BelaPlatform/gliss-hardware/README.md

# gliss-hardware

You can find the source KiCad files for the Gliss module in this repository. This project is open hardware and under the Creative Commons Share Alike license 4.0.
The firmware can be found in the repository https://github.com/BelaPlatform/gliss-firmware
