BelaPlatform/gliss-hardware/3Dmodels/WS2812-2020.STEP

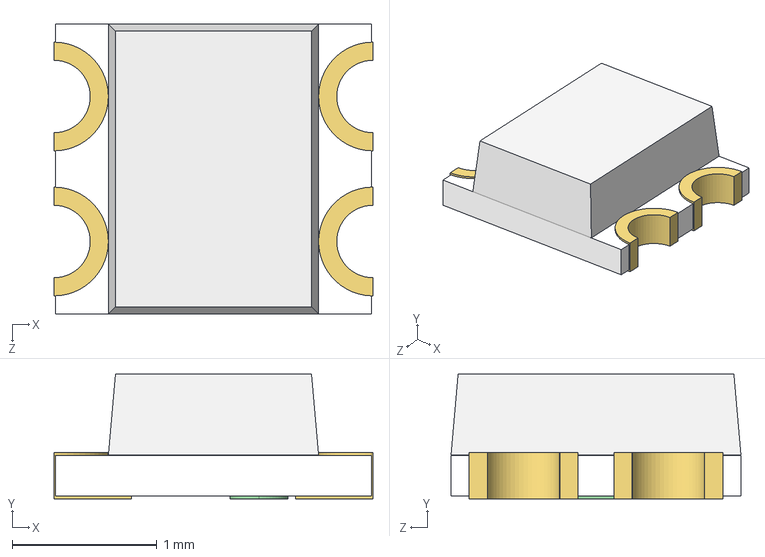
[picture p1: CAD file, 2023-10-27]
3Dmodels/WS2812-2020.STEP
2.20 x 0.86 x 2.00 mm
