BelaPlatform/gliss-hardware/3Dmodels/ECS-.327-12.5-16-TR.step

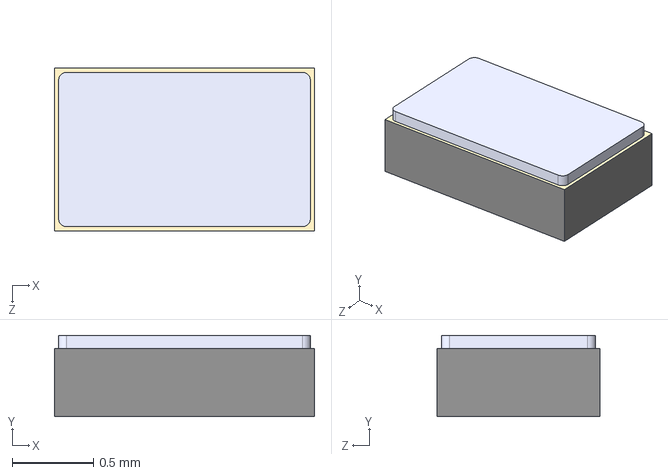
[picture p2: CAD file, 2023-10-27]
3Dmodels/ECS-.327-12.5-16-TR.step
1.60 x 0.5 x 1.00 mm
