BelaPlatform/gliss-hardware/3Dmodels/Thonkicon.step

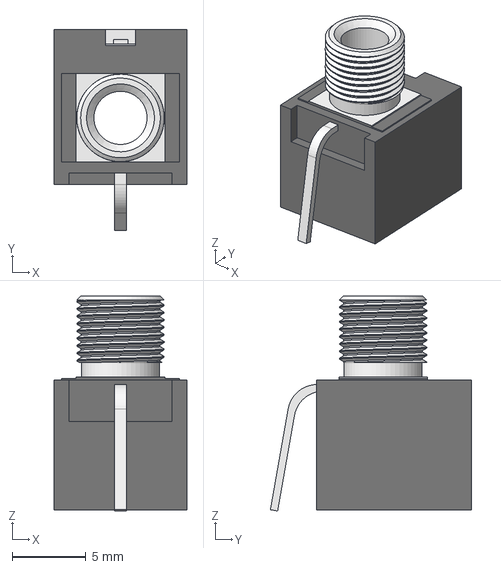
[picture p3: CAD file, 2023-10-27]
3Dmodels/Thonkicon.step
9.00 x 13.6 x 14.6 mm
