BelaPlatform/gliss-hardware/3Dmodels/ST1S06PUR.step

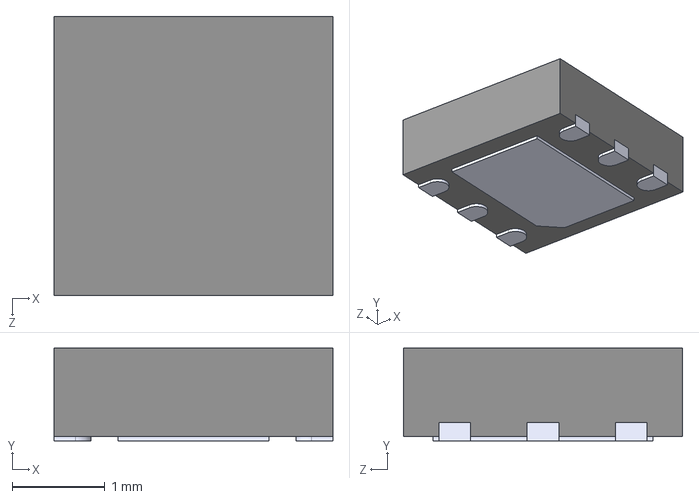
[picture p4: CAD file, 2023-10-27]
3Dmodels/ST1S06PUR.step
3.00 x 1 x 3.00 mm
