BelaPlatform/gliss-hardware/3Dmodels/R-78E5.0-0.5.STEP

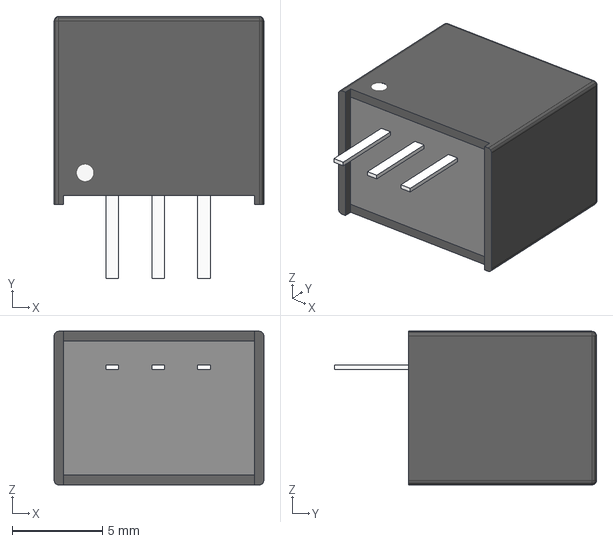
[picture p5: CAD file, 2023-10-27]
3Dmodels/R-78E5.0-0.5.STEP
11.6 x 14.5 x 8.51 mm
