BelaPlatform/gliss-hardware/3Dmodels/TPD2E001DZDR--3DModel-STEP-56544.STEP

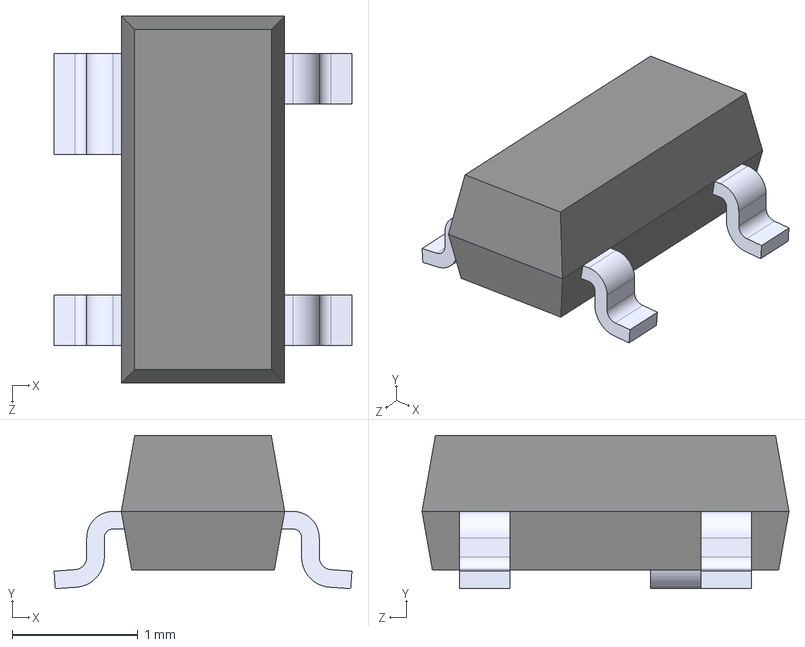
[picture p6: CAD file, 2023-10-27]
3Dmodels/TPD2E001DZDR--3DModel-STEP-56544.STEP
2.37 x 1.22 x 2.92 mm
