BelaPlatform/gliss-hardware/3Dmodels/HIGHLY_PB6149L.STEP

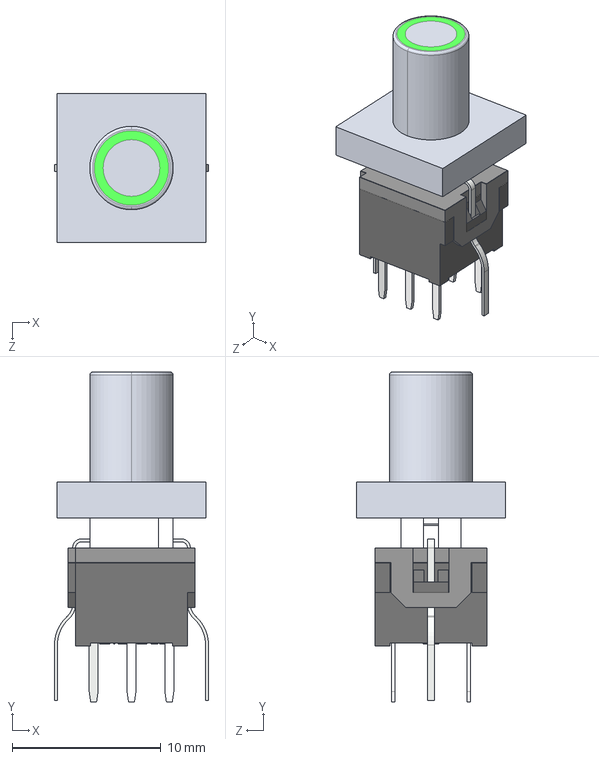
[picture p7: CAD file, 2023-10-27]
3Dmodels/HIGHLY_PB6149L.STEP
10.3 x 22.1 x 10.0 mm
Przycisk_Signal_Green_Domyślna
Switch_DPDT_bistable_Domyślna
