BelaPlatform/gliss-hardware/3Dmodels/SN74LV1T34DCKR.STEP

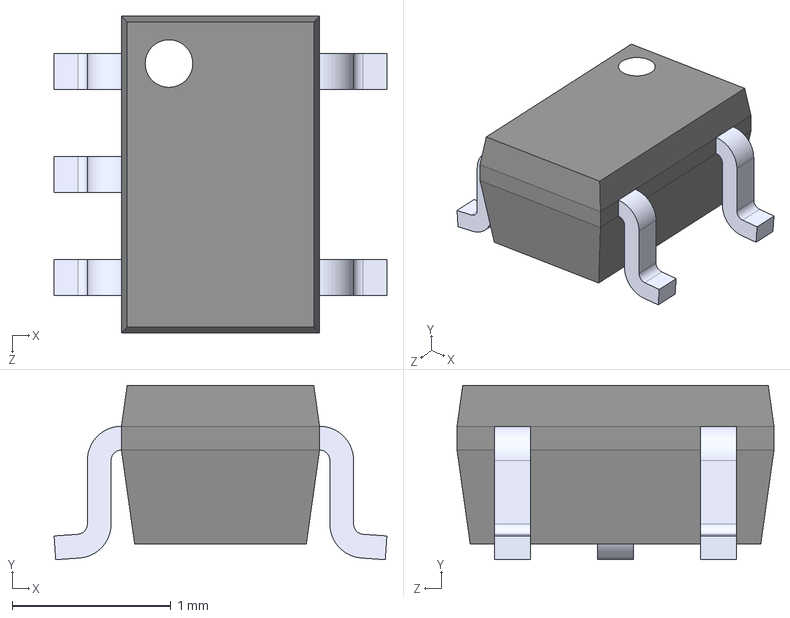
[picture p8: CAD file, 2023-10-27]
3Dmodels/SN74LV1T34DCKR.STEP
2.10 x 1.10 x 2.00 mm
