BelaPlatform/gliss-hardware/3Dmodels/10118194-0001LF--3DModel-STEP-56544.STEP

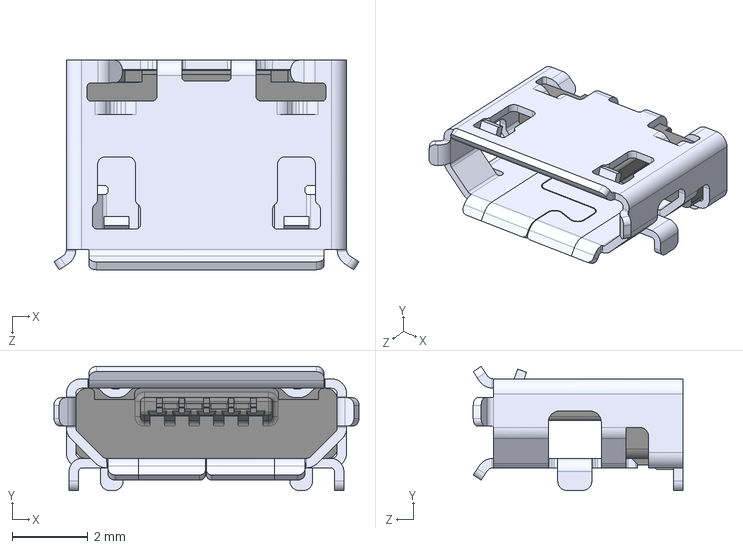
[picture p9: CAD file, 2023-10-27]
3Dmodels/10118194-0001LF--3DModel-STEP-56544.STEP
8.05 x 3.27 x 5.53 mm
