BelaPlatform/gliss-hardware/gliss_faceplate/gliss_faceplate.kicad_pcb

## KiCad design gliss_faceplate/gliss_faceplate.kicad_pcb (2023-10-27)

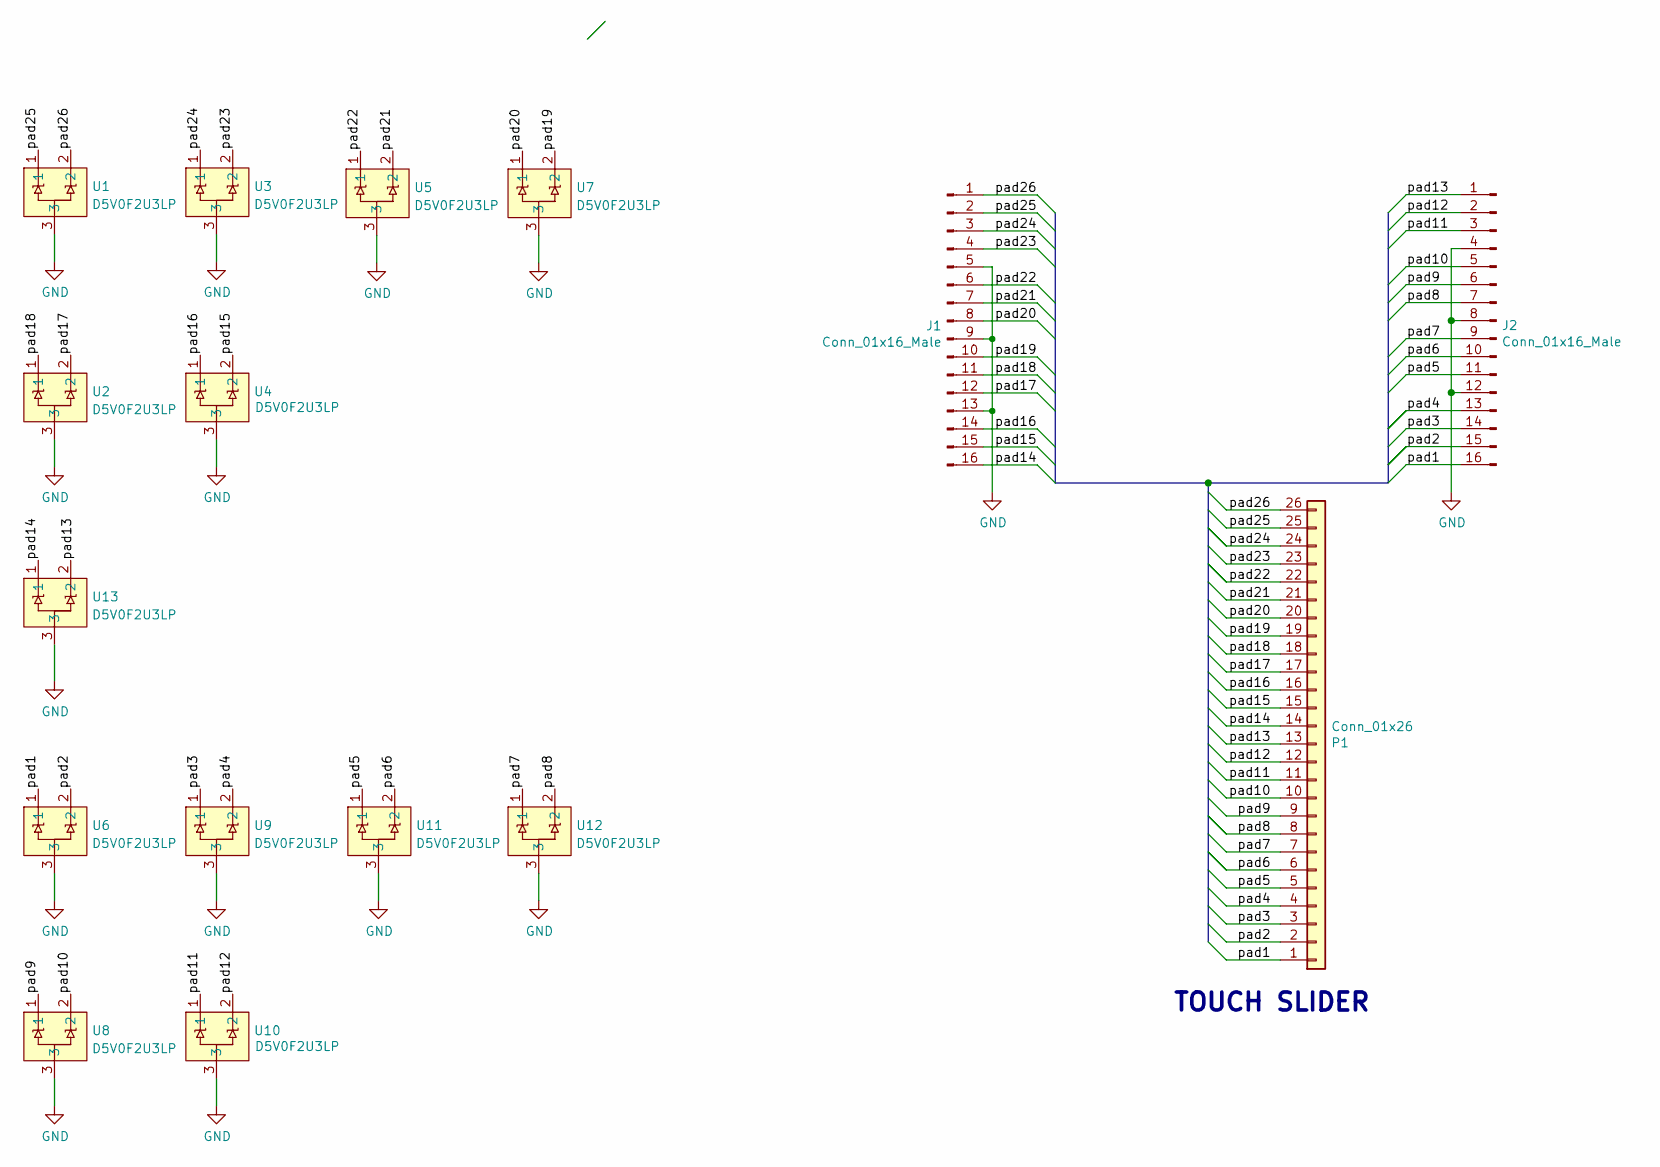
[picture p10: schematic gliss_faceplate.kicad_sch, Gliss [Faceplate]

Parts:
J1, J2: Conn_01x16_Male; PinHeader_1x16_P2.54mm_Vertical_SMD_Pin1Right
P1: Conn_01x26; TouchSlider-26_89.5x17.8mm
U1, U2, U3, U4, U5, U6, U7, U8, U9, U10, U11, U12, U13: D5V0F2U3LP; Diodes_DFN1006-3

Connections:
/pad1: J2.16, P1.1, U6.1
/pad2: J2.15, P1.2, U6.2
/pad3: J2.14, P1.3, U9.1
/pad4: J2.13, P1.4, U9.2
/pad5: J2.11, P1.5, U11.1
/pad6: J2.10, P1.6, U11.2
/pad7: J2.9, P1.7, U12.1
/pad8: J2.7, P1.8, U12.2
/pad9: J2.6, P1.9, U8.1
/pad10: J2.5, P1.10, U8.2
/pad11: J2.3, P1.11, U10.1
/pad12: J2.2, P1.12, U10.2
/pad13: J2.1, P1.13
/pad14: J1.16, P1.14, U13.1
/pad15: J1.15, P1.15, U4.2
/pad16: J1.14, P1.16, U4.1
/pad17: J1.12, P1.17, U2.2
/pad18: J1.11, P1.18, U2.1
/pad19: J1.10, P1.19, U7.2
/pad20: J1.8, P1.20, U7.1
/pad21: J1.7, P1.21, U5.2
/pad22: J1.6, P1.22, U5.1
/pad23: J1.4, P1.23, U3.2
/pad24: J1.3, P1.24, U3.1
/pad25: J1.2, P1.25, U1.1
/pad26: J1.1, P1.26, U1.2
GND: J1.5, J1.9, J1.13, J2.4, J2.8, J2.12, U1.3, U2.3, U3.3, U4.3, U5.3, U6.3, U7.3, U8.3, U9.3, U10.3, U11.3, U12.3, U13.3

Notes on the sheet:
TOUCH SLIDER

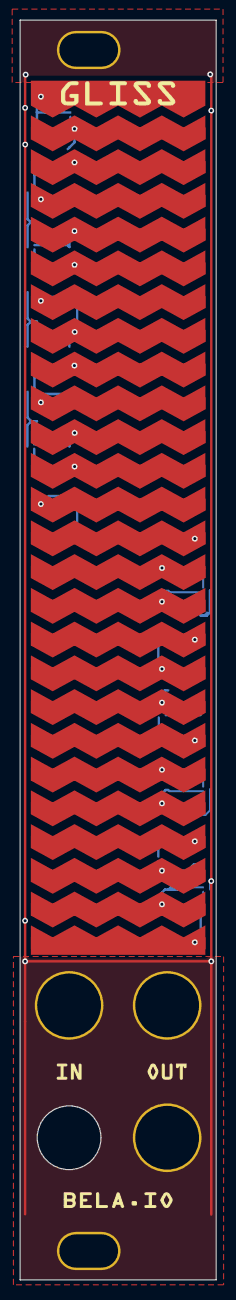
[picture p11: board gliss_faceplate.kicad_pcb from above]

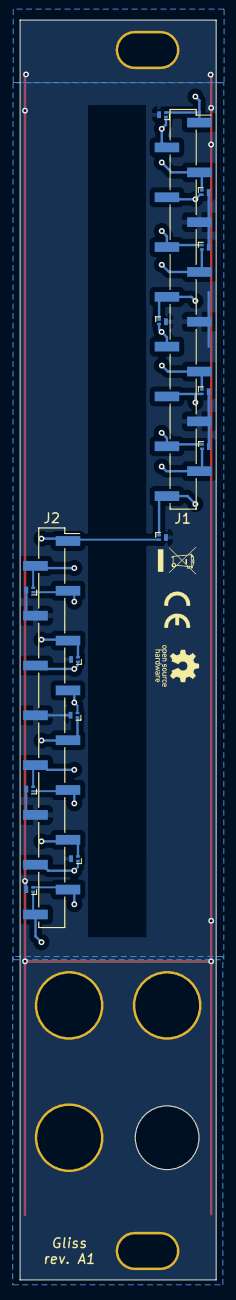
[picture p12: board gliss_faceplate.kicad_pcb from below]

Board: 2 copper layers, 20.0 x 128.5 mm, 17 parts (15 on the bottom side), 27 nets.

Other parts of the board:
outline: Val**; gliss_edge_silkscreen
