BelaPlatform/gliss-hardware/gliss_main/gliss_main.kicad_pcb

## KiCad design gliss_main/gliss_main.kicad_pcb (2023-10-27)

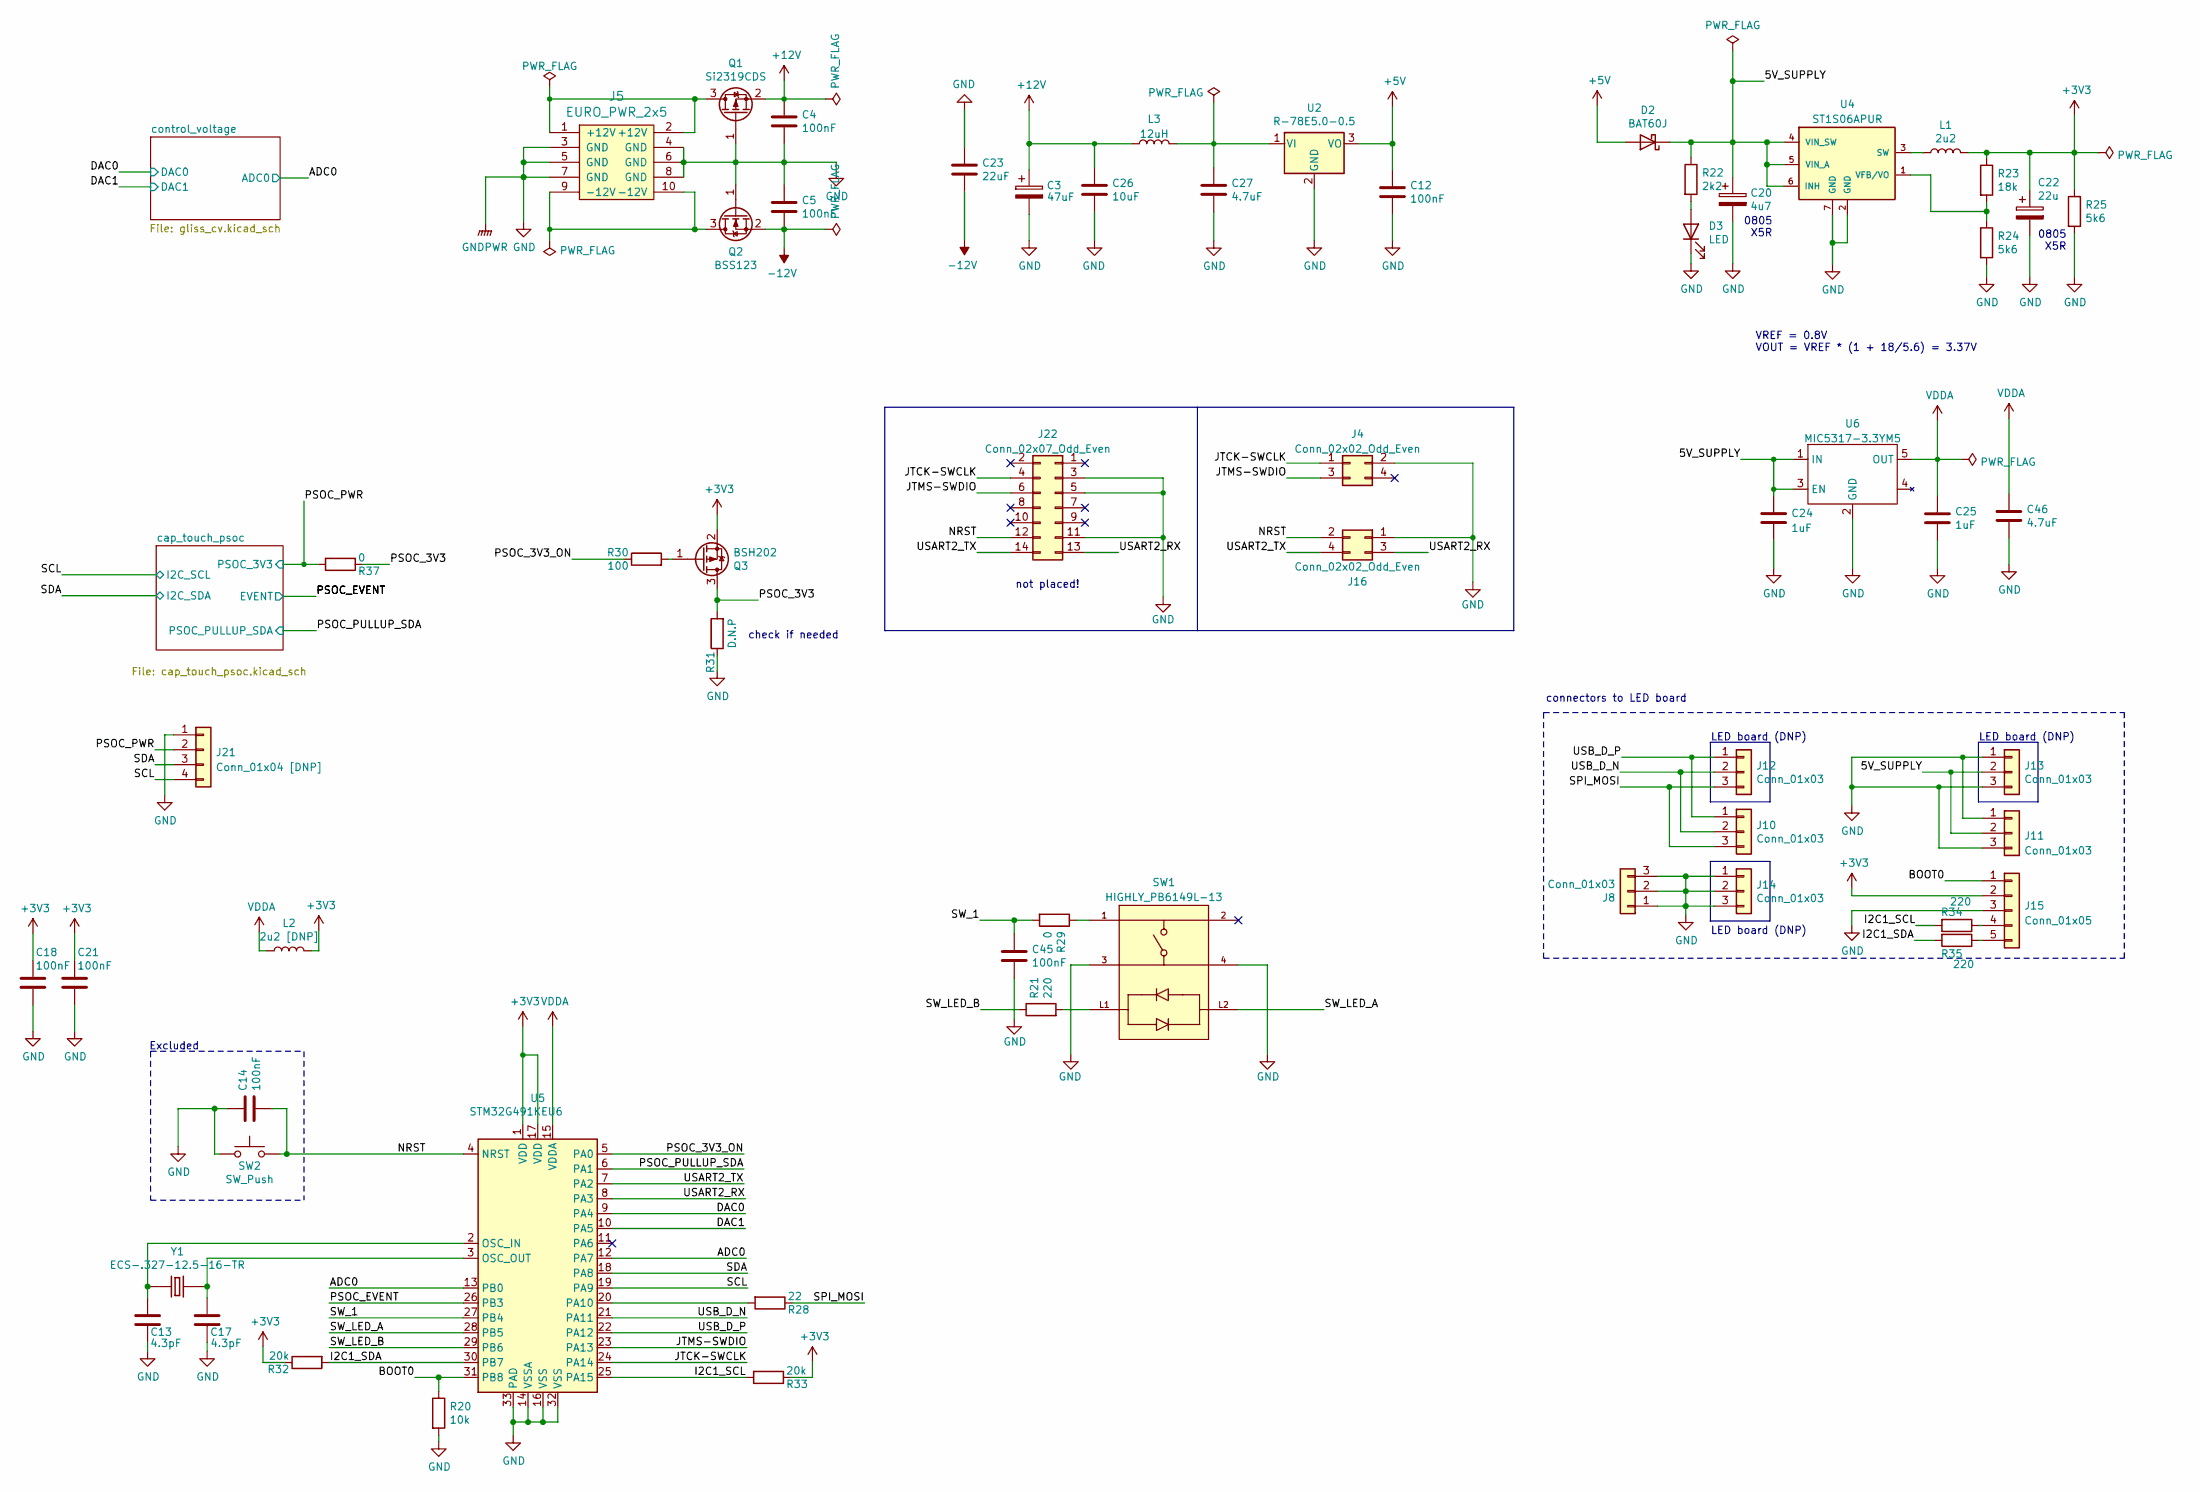
[picture p13: schematic gliss_main.kicad_sch]

Parts:
C3: 47uF; CP_Radial_D5.0mm_P2.00mm
C4, C5: 100nF; C_0805_2012Metric
C12: 100nF; C_0603_1608Metric
C13, C17: 4.3pF; C_0402_1005Metric
C14, C18, C21, C45: 100nF; C_0402_1005Metric
C20: 4u7; C_0805_2012Metric
C22: 22u; C_0805_2012Metric
C23: 22uF; C_0805_2012Metric
C24, C25: 1uF; C_0402_1005Metric
C26: 10uF; C_0603_1608Metric
C27: 4.7uF; C_0603_1608Metric
C46: 4.7uF; C_0402_1005Metric
D2: BAT60J; D_SOD-323
D3: LED; LED_0603_1608Metric
J4, J16: Conn_02x02_Odd_Even; PinHeader_2x02_P1.27mm_Vertical
J5: EURO_PWR_2x5; PinHeader_2x05_P2.54mm_Vertical
J8, J10, J11: Conn_01x03; PinHeader_1x03_P2.54mm_Vertical
J12, J13, J14: Conn_01x03; PinHeader_1x03_P2.54mm_Vertical_SMD_Pin1Left
J15: Conn_01x05; PinHeader_1x05_P2.54mm_Vertical
J21: Conn_01x04 [DNP]; PinHeader_1x04_P1.27mm_Vertical
J22: Conn_02x07_Odd_Even; PinHeader_2x07_P1.27mm_Vertical
L1: 2u2; L_0603_1608Metric
L2: 2u2 [DNP]; L_0603_1608Metric
L3: 12uH; L_1210_3225Metric
Q1: Si2319CDS; SOT-23
Q2: BSS123; SOT-23
Q3: BSH202; SOT-23
R20: 10k; R_0402_1005Metric
R21, R34, R35: 220; R_0402_1005Metric
R22: 2k2; R_0402_1005Metric
R23: 18k; R_0402_1005Metric
R24, R25: 5k6; R_0402_1005Metric
R28: 22; R_0402_1005Metric
R29, R37: 0; R_0402_1005Metric
R30: 100; R_0402_1005Metric
R31: D.N.P; R_0402_1005Metric
R32, R33: 20k; R_0402_1005Metric
SW1: HIGHLY_PB6149L-13; HIGHLY_PB6149L_v4
SW2: SW_Push; SW_SPST_B3U-1000P
U2: R-78E5.0-0.5; R-78-xxx-0.5
U4: ST1S06APUR; DFN-6-1EP_3x3mm_P0.95mm_EP1.7x2.6mm
U5: STM32G491KEU6; QFN-32-1EP_5x5mm_P0.5mm_EP3.45x3.45mm
U6: MIC5317-3.3YM5; TSOT-23-5
Y1: ECS-.327-12.5-16-TR; XTAL_ECS-.327-12.5-16-TR

Connections:
+3V3: C18.1, C21.1, C22.1, J15.2, L1.2, L2.2, Q3.2 (S), R23.1, R25.1, R32.1, R33.1, U5.1 (VDD), U5.17 (VDD); also elsewhere on the board
+5V: C12.1, D2.2 (A), U2.3 (VO)
+12V: C3.1, C4.1, C26.1, L3.1, Q1.2 (S); also elsewhere on the board
-12V: C5.2, C23.2, Q2.2 (S); also elsewhere on the board
/5V_SUPPLY: C20.1, C24.1, D2.1 (K), J11.2, J13.2, R22.1, U4.4 (VIN_SW), U4.5 (VIN_A), U4.6 (INH), U6.1 (IN), U6.3 (EN)
/ADC0: U5.12 (PA7), U5.13 (PB0); also elsewhere on the board
/BOOT0: J15.1, R20.1, U5.31 (PB8)
/DAC0: U5.9 (PA4); also elsewhere on the board
/DAC1: U5.10 (PA5); also elsewhere on the board
/I2C1_SCL: R33.2, R34.2, U5.25 (PA15)
/I2C1_SDA: R32.2, R35.2, U5.30 (PB7)
/JTCK-SWCLK: J4.1, J22.4, U5.24 (PA14)
/JTMS-SWDIO: J4.3, J22.6, U5.23 (PA13)
/NRST: C14.2, J16.2, J22.12, SW2.2, U5.4 (NRST)
/PSOC_3V3: Q3.3 (D), R31.2, R37.1
/PSOC_3V3_ON: R30.1, U5.5 (PA0)
/PSOC_EVENT: U5.26 (PB3); also elsewhere on the board
/PSOC_PULLUP_SDA: U5.6 (PA1); also elsewhere on the board
/PSOC_PWR: J21.2, R37.2; also elsewhere on the board
/SCL: J21.4, U5.19 (PA9); also elsewhere on the board
/SDA: J21.3, U5.18 (PA8); also elsewhere on the board
/SPI_MOSI: J10.3, J12.3, R28.1
/SW_1: C45.1, R29.2, U5.27 (PB4)
/SW_LED_A: SW1.L2, U5.28 (PB5)
/SW_LED_B: R21.1, U5.29 (PB6)
/USART2_RX: J16.3, J22.13, U5.8 (PA3)
/USART2_TX: J16.4, J22.14, U5.7 (PA2)
/USB_D_N: J10.2, J12.2, U5.21 (PA11)
/USB_D_P: J10.1, J12.1, U5.22 (PA12)
GND: C3.2, C4.2, C5.1, C12.2, C13.2, C14.1, C17.2, C18.2, C20.2, C21.2, C22.2, C23.1, C24.2, C25.2, C26.2, C27.2, C45.2, C46.2, D3.1 (K), J4.2, J5.3 (GND), J5.4 (GND), J5.5 (GND), J5.6 (GND), J5.7 (GND), J5.8 (GND), J8.1, J8.2, J8.3, J11.1, J11.3, J13.1, J13.3, J14.1, J14.2, J14.3, J15.3, J16.1, J21.1, J22.3, J22.5, J22.11, Q1.1 (G), Q2.1 (G), R20.2, R24.2, R25.2, R31.1, SW1.3, SW1.4, SW2.1, U2.2 (GND), U4.2 (GND), U4.7 (GND), U5.14 (VSSA), U5.16 (VSS), U5.32 (VSS), U5.33 (PAD), U6.2 (GND); also elsewhere on the board
unnamed: C13.1, U5.2 (OSC_IN), Y1.1
unnamed: C17.1, U5.3 (OSC_OUT), Y1.2
unnamed: C27.1, L3.2, U2.1 (VI)
unnamed: D3.2 (A), R22.2
unnamed: J5.1 (+12V), J5.2 (+12V), Q1.3 (D)
unnamed: J5.9 (-12V), J5.10 (-12V), Q2.3 (D)
unnamed: J15.4, R34.1
unnamed: J15.5, R35.1
unnamed: L1.1, U4.3 (SW)
unnamed: Q3.1 (G), R30.2
unnamed: R21.2, SW1.L1
unnamed: R23.2, R24.1, U4.1 (VFB/VO)
unnamed: R28.2, U5.20 (PA10)
unnamed: R29.1, SW1.1
VDDA: C25.1, C46.1, L2.1, U5.15 (VDDA), U6.5 (OUT)

Notes on the sheet:
Excluded
LED board (DNP)
0805 X5R
connectors to LED board
VREF = 0.8V VOUT = VREF * (1 + 18/5.6) = 3.37V
check if needed
not placed!

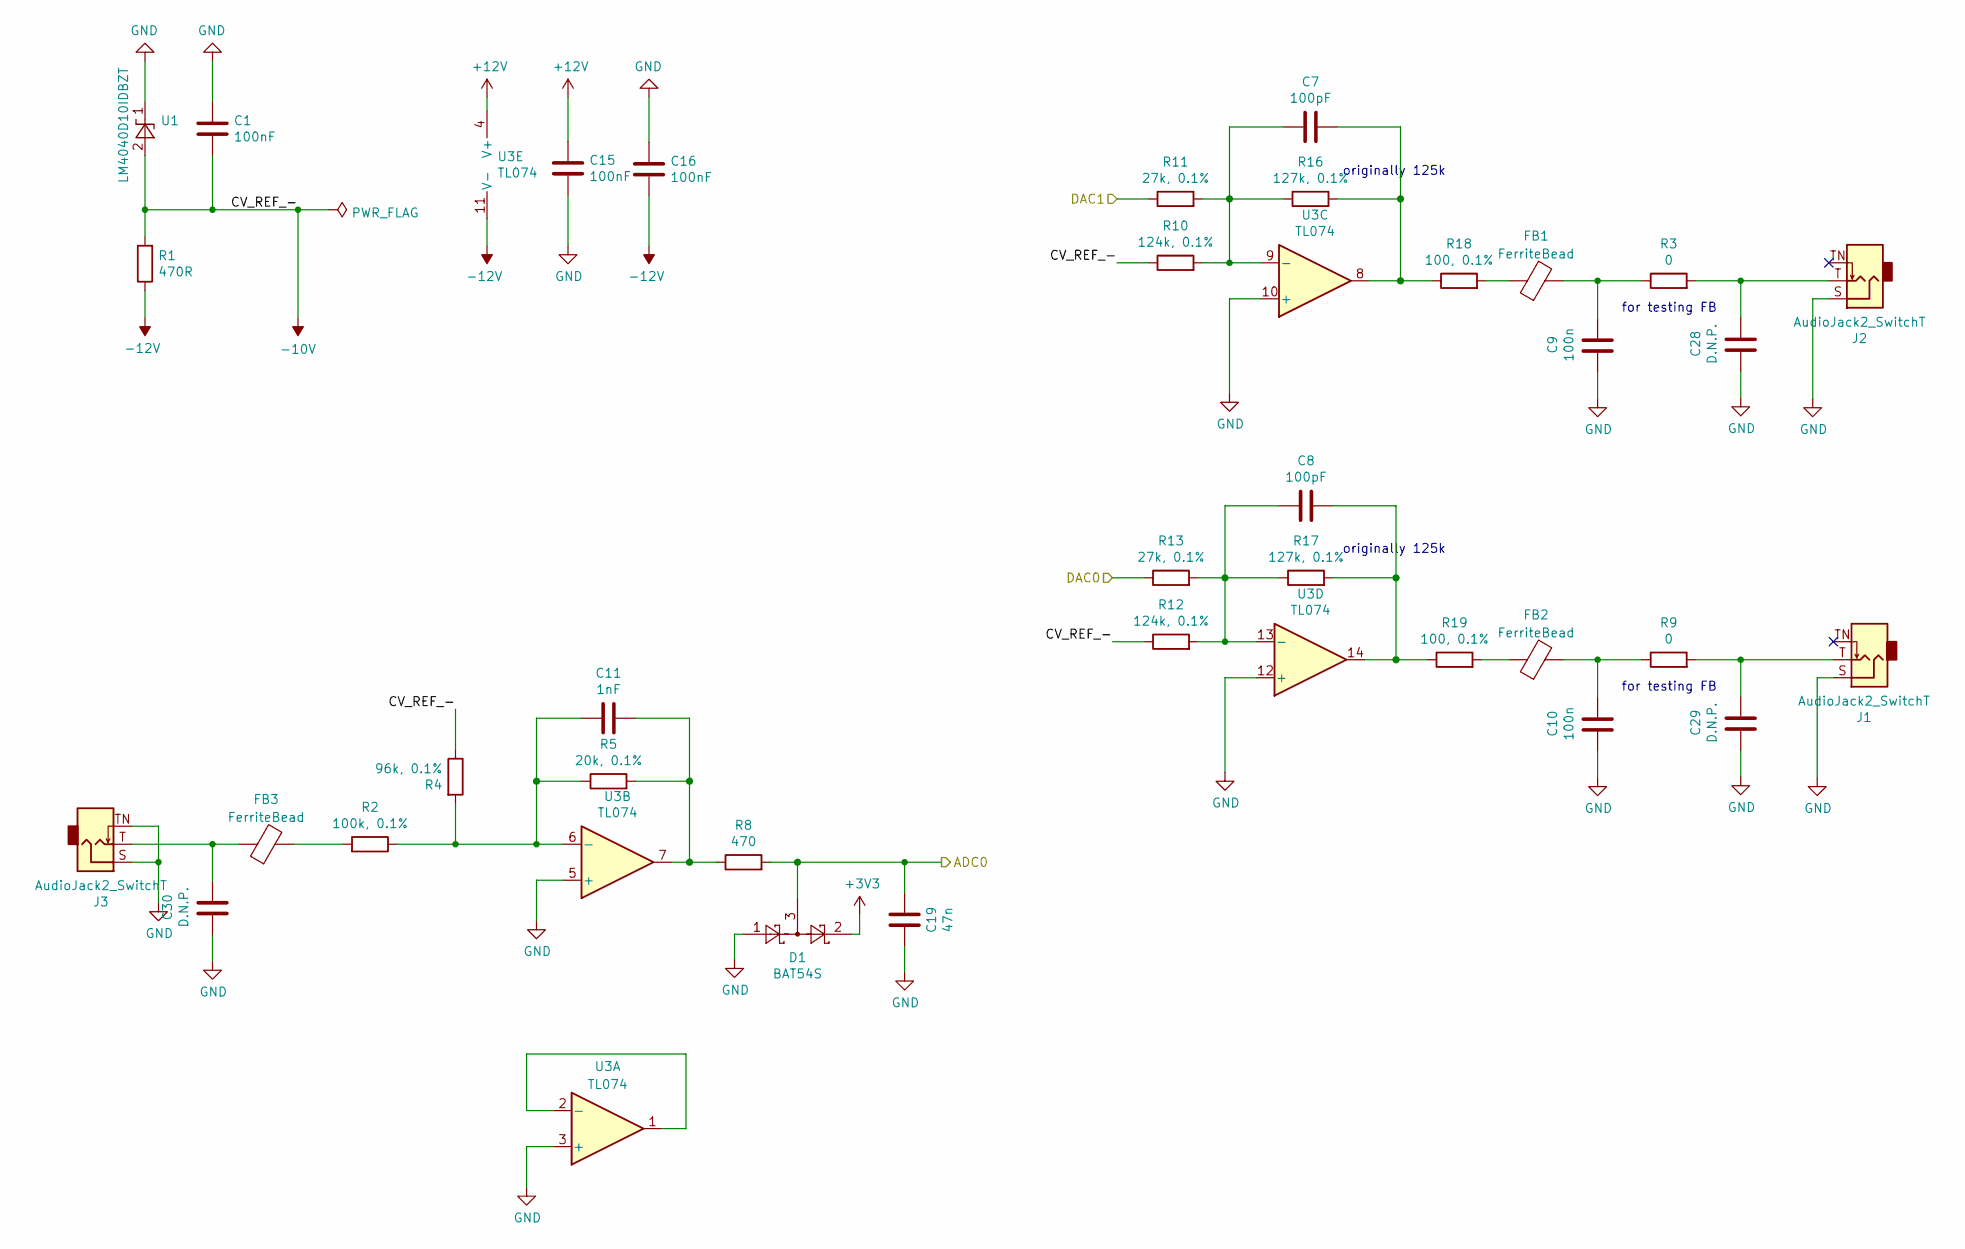
[picture p14: schematic gliss_cv.kicad_sch]

Parts:
C1, C15, C16: 100nF; C_0402_1005Metric
C7, C8: 100pF; C_0402_1005Metric
C9, C10: 100n; C_0402_1005Metric
C11: 1nF; C_0402_1005Metric
C19: 47n; C_0402_1005Metric
C28, C29, C30: D.N.P.; C_0402_1005Metric
D1: BAT54S; SOT-23
FB1, FB2, FB3: FerriteBead; L_0402_1005Metric
J1, J2, J3: AudioJack2_SwitchT; Jack_3.5mm_QingPu_WQP-PJ398SM_Vertical_CircularHoles
R1: 470R; R_0402_1005Metric
R2: 100k, 0.1%; R_0402_1005Metric
R3, R9: 0; R_0402_1005Metric
R4: 96k, 0.1%; R_0402_1005Metric
R5: 20k, 0.1%; R_0402_1005Metric
R8: 470; R_0402_1005Metric
R10, R12: 124k, 0.1%; R_0402_1005Metric
R11, R13: 27k, 0.1%; R_0402_1005Metric
R16, R17: 127k, 0.1%; R_0402_1005Metric
R18, R19: 100, 0.1%; R_0402_1005Metric
U1: LM4040D10IDBZT; SOT-23
U3: TL074

Connections:
+3V3: D1.2; also elsewhere on the board
+12V: C15.1, U3.4 (V+); also elsewhere on the board
-10V: C1.2, R1.2, R4.1, R10.1, R12.1, U1.2 (A)
-12V: C16.2, R1.1, U3.11 (V-); also elsewhere on the board
/ADC0: C19.2, D1.3, R8.2; also elsewhere on the board
/DAC0: R13.1; also elsewhere on the board
/DAC1: R11.1; also elsewhere on the board
GND: C1.1, C9.1, C10.1, C15.2, C16.1, C19.1, C28.1, C29.1, C30.1, D1.1, J1.S, J2.S, J3.S, J3.TN, U1.1 (K), U3.3 (+), U3.5 (+), U3.10 (+), U3.12 (+); also elsewhere on the board
unnamed: C7.1, R10.2, R11.2, R16.1, U3.9 (-)
unnamed: C7.2, R16.2, R18.1, U3.8
unnamed: C8.1, R12.2, R13.2, R17.1, U3.13 (-)
unnamed: C8.2, R17.2, R19.1, U3.14
unnamed: C9.2, FB1.2, R3.1
unnamed: C10.2, FB2.2, R9.1
unnamed: C11.1, R2.1, R4.2, R5.1, U3.6 (-)
unnamed: C11.2, R5.2, R8.1, U3.7
unnamed: C28.2, J2.T, R3.2
unnamed: C29.2, J1.T, R9.2
unnamed: C30.2, FB3.1, J3.T
unnamed: FB1.1, R18.2
unnamed: FB2.1, R19.2
unnamed: FB3.2, R2.2
unnamed: U3.1, U3.2 (-)

Notes on the sheet:
originally 125k
for testing FB

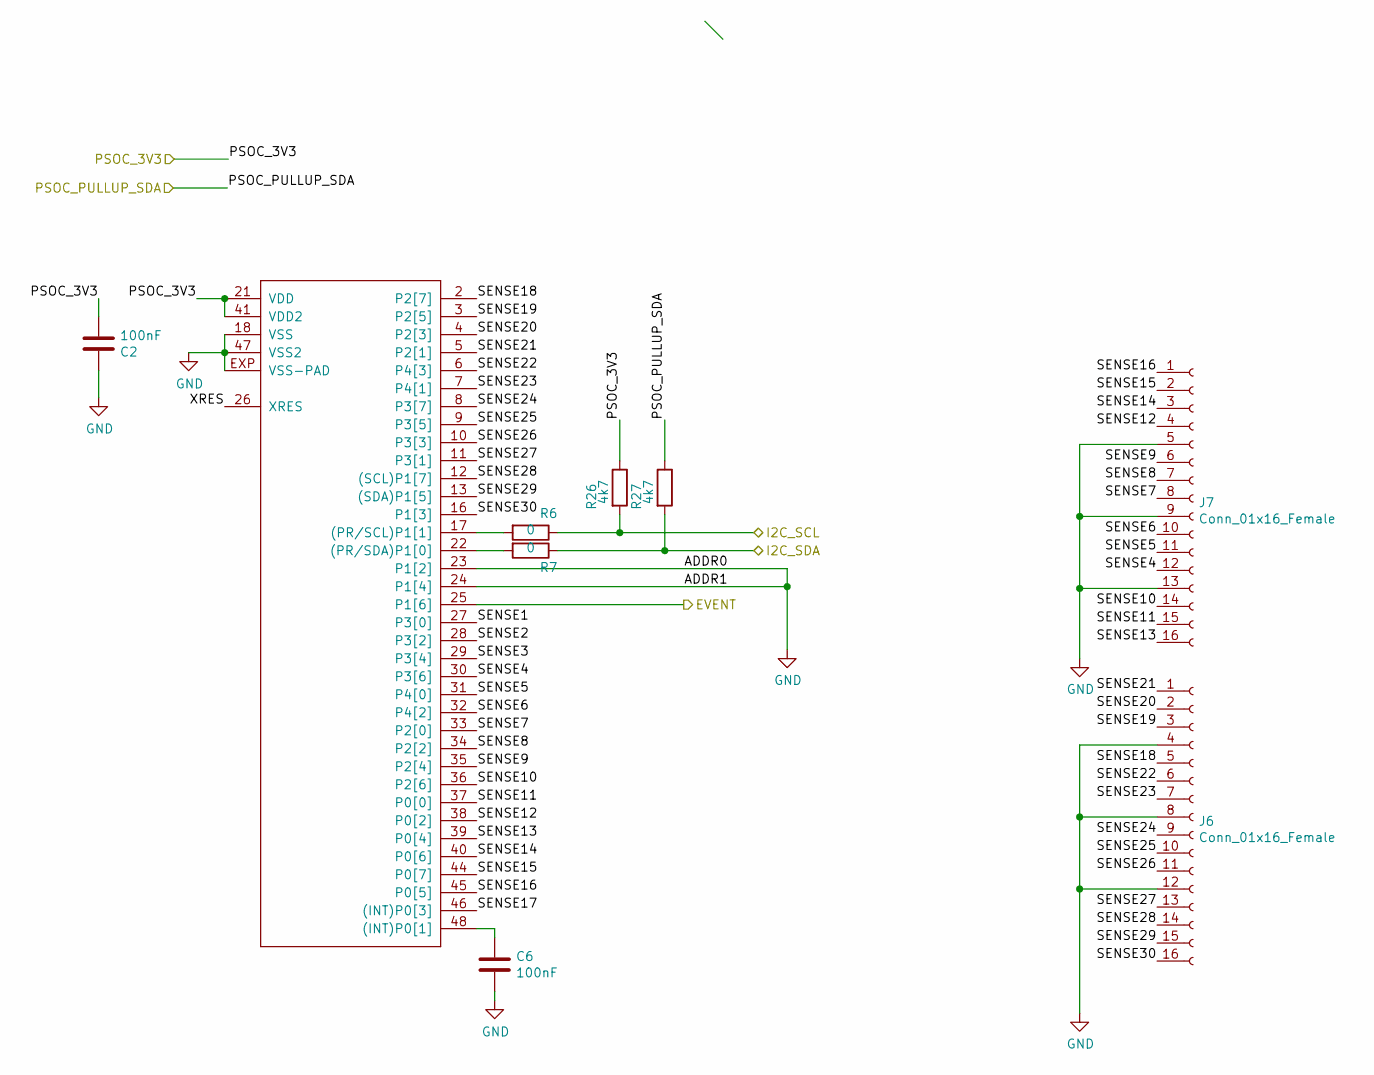
[picture p15: schematic cap_touch_psoc.kicad_sch]

Parts:
C2, C6: 100nF; C_0402_1005Metric
J6, J7: Conn_01x16_Female; PinHeader_1x16_P2.54mm_Vertical
R6, R7: 0; R_0402_1005Metric
R26, R27: 4k7; R_0402_1005Metric
U30: CY8C206X6A; QFN48-LEADS

Connections:
/PSOC_EVENT: U30.25 (P1[6]); also elsewhere on the board
/PSOC_PULLUP_SDA: R27.1; also elsewhere on the board
/PSOC_PWR: C2.2, R26.1, U30.21 (VDD), U30.41 (VDD2); also elsewhere on the board
/SCL: R6.1, R26.2; also elsewhere on the board
/SDA: R7.1, R27.2; also elsewhere on the board
/cap_touch_psoc/SENSE1: U30.27 (P3[0])
/cap_touch_psoc/SENSE2: U30.28 (P3[2])
/cap_touch_psoc/SENSE3: U30.29 (P3[4])
/cap_touch_psoc/SENSE4: J7.12, U30.30 (P3[6])
/cap_touch_psoc/SENSE5: J7.11, U30.31 (P4[0])
/cap_touch_psoc/SENSE6: J7.10, U30.32 (P4[2])
/cap_touch_psoc/SENSE7: J7.8, U30.33 (P2[0])
/cap_touch_psoc/SENSE8: J7.7, U30.34 (P2[2])
/cap_touch_psoc/SENSE9: J7.6, U30.35 (P2[4])
/cap_touch_psoc/SENSE10: J7.14, U30.36 (P2[6])
/cap_touch_psoc/SENSE11: J7.15, U30.37 (P0[0])
/cap_touch_psoc/SENSE12: J7.4, U30.38 (P0[2])
/cap_touch_psoc/SENSE13: J7.16, U30.39 (P0[4])
/cap_touch_psoc/SENSE14: J7.3, U30.40 (P0[6])
/cap_touch_psoc/SENSE15: J7.2, U30.44 (P0[7])
/cap_touch_psoc/SENSE16: J7.1, U30.45 (P0[5])
/cap_touch_psoc/SENSE17: U30.46 ((INT)P0[3])
/cap_touch_psoc/SENSE18: J6.5, U30.2 (P2[7])
/cap_touch_psoc/SENSE19: J6.3, U30.3 (P2[5])
/cap_touch_psoc/SENSE20: J6.2, U30.4 (P2[3])
/cap_touch_psoc/SENSE21: J6.1, U30.5 (P2[1])
/cap_touch_psoc/SENSE22: J6.6, U30.6 (P4[3])
/cap_touch_psoc/SENSE23: J6.7, U30.7 (P4[1])
/cap_touch_psoc/SENSE24: J6.9, U30.8 (P3[7])
/cap_touch_psoc/SENSE25: J6.10, U30.9 (P3[5])
/cap_touch_psoc/SENSE26: J6.11, U30.10 (P3[3])
/cap_touch_psoc/SENSE27: J6.13, U30.11 (P3[1])
/cap_touch_psoc/SENSE28: J6.14, U30.12 ((SCL)P1[7])
/cap_touch_psoc/SENSE29: J6.15, U30.13 ((SDA)P1[5])
/cap_touch_psoc/SENSE30: J6.16, U30.16 (P1[3])
/cap_touch_psoc/XRES: U30.26 (XRES)
GND: C2.1, C6.2, J6.4, J6.8, J6.12, J7.5, J7.9, J7.13, U30.18 (VSS), U30.23 (P1[2]), U30.24 (P1[4]), U30.47 (VSS2), U30.EXP (VSS-PAD); also elsewhere on the board
unnamed: C6.1, U30.48 ((INT)P0[1])
unnamed: R6.2, U30.17 ((PR/SCL)P1[1])
unnamed: R7.2, U30.22 ((PR/SDA)P1[0])

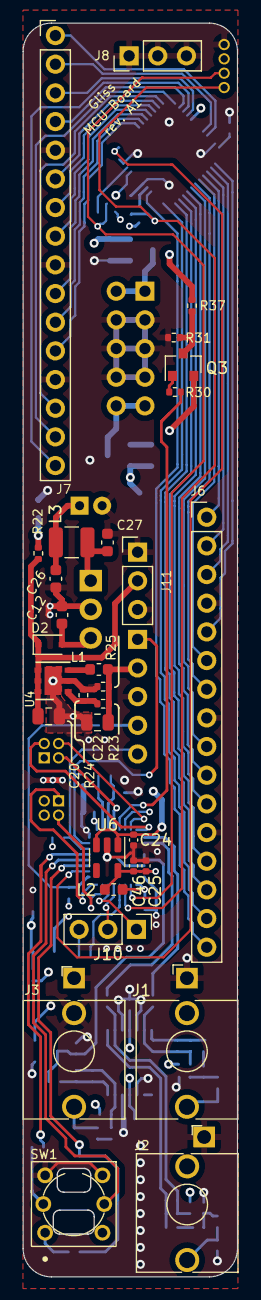
[picture p16: board gliss_main.kicad_pcb from above]

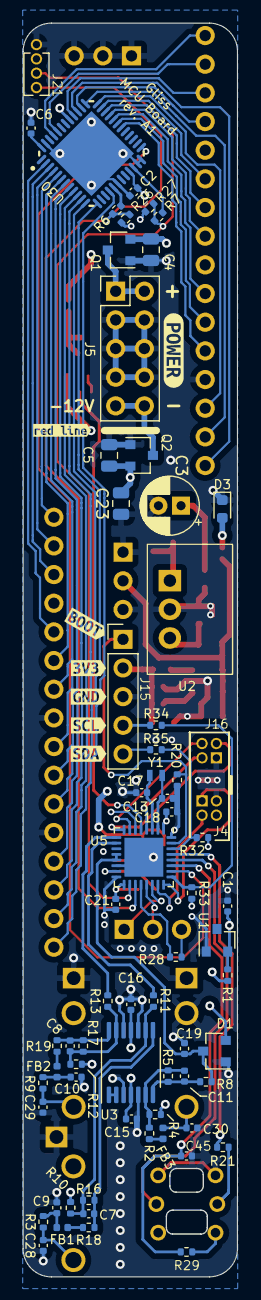
[picture p17: board gliss_main.kicad_pcb from below]

Board: 4 copper layers, 19.0 x 111.1 mm, 107 parts (75 on the bottom side), 90 nets.

Other parts of the board:
kibuzzard-639244A3: G***; kibuzzard-639244A3
kibuzzard-639247C2: G***; kibuzzard-639247C2
kibuzzard-6392461D: G***; kibuzzard-6392461D
kibuzzard-6392462F: G***; kibuzzard-6392462F
kibuzzard-6392472E: G***; kibuzzard-6392472E
kibuzzard-63924611: G***; kibuzzard-63924611
kibuzzard-63924626: G***; kibuzzard-63924626
outline: Val**; gliss_edge_silkscreen_user_graphics
