BelaPlatform/gliss-hardware/gliss_led/gliss_led.kicad_pcb

## KiCad design gliss_led/gliss_led.kicad_pcb (2023-10-27)

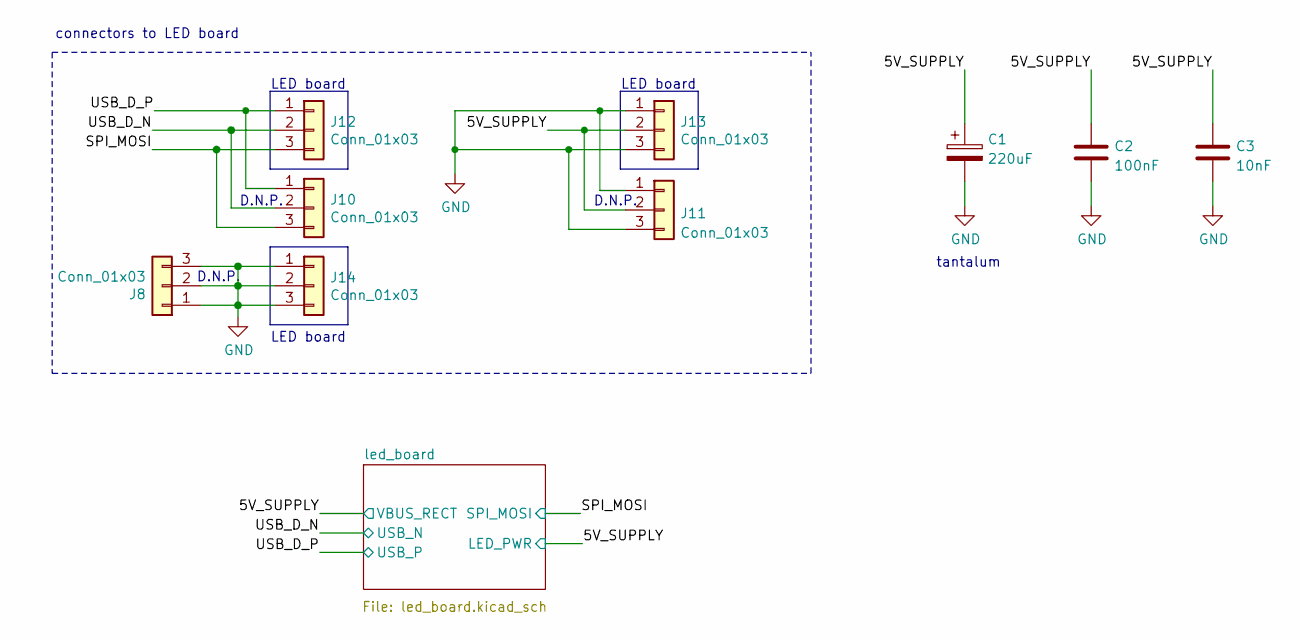
[picture p18: schematic gliss_led.kicad_sch]

Parts:
C1: 220uF; CP_EIA-3528-15_AVX-H
C2: 100nF; C_0402_1005Metric
C3: 10nF; C_0402_1005Metric
J8, J10, J11: Conn_01x03; PinHeader_1x03_P2.54mm_Vertical
J12, J13, J14: Conn_01x03; PinHeader_1x03_P2.54mm_Vertical_SMD_Pin1Left

Connections:
/5V_SUPPLY: C1.1, C2.1, C3.1, J11.2, J13.2; also elsewhere on the board
/SPI_MOSI: J10.3, J12.3; also elsewhere on the board
/USB_D_N: J10.2, J12.2; also elsewhere on the board
/USB_D_P: J10.1, J12.1; also elsewhere on the board
GND: C1.2, C2.2, C3.2, J8.1, J8.2, J8.3, J11.1, J11.3, J13.1, J13.3, J14.1, J14.2, J14.3; also elsewhere on the board

Notes on the sheet:
LED board
LED board
D.N.P.
connectors to LED board
tantalum

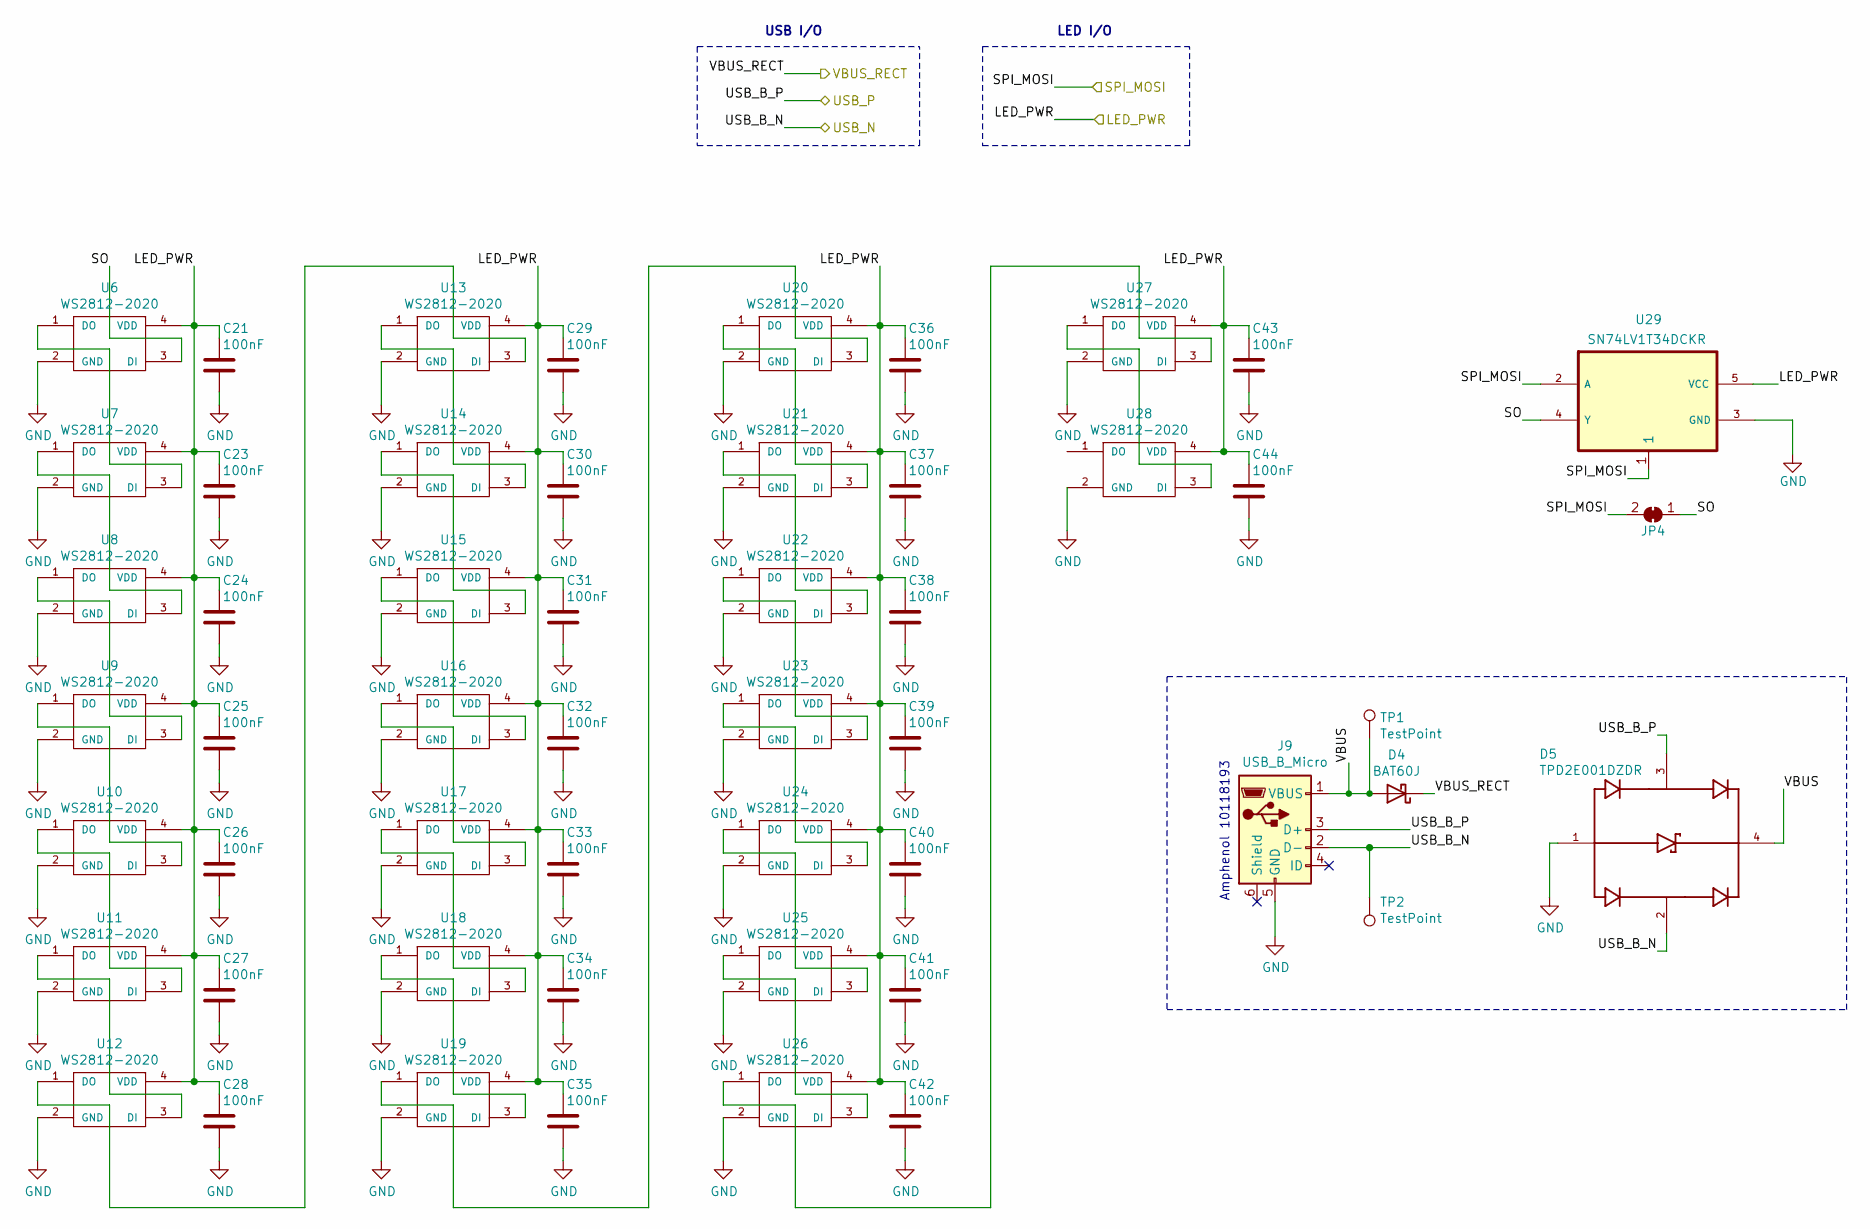
[picture p19: schematic led_board.kicad_sch]

Parts:
C21, C23, C24, C25, C26, C27, C28, C29, C30, C31, C32, C33, C34, C35, C36, C37, C38, C39, C40, C41, C42, C43, C44: 100nF; C_0402_1005Metric
D4: BAT60J; D_SOD-323
D5: TPD2E001DZDR; SOT192P237X122-4N; PARTREV I
J9: USB_B_Micro; USB_Micro-B_Amphenol_10118194_Horizontal
JP4: SolderJumper_2_Bridged; SolderJumper-2_P1.3mm_Open_TrianglePad1.0x1.5mm
TP1, TP2: TestPoint; TestPoint_Pad_D1.5mm
U6, U7, U8, U9, U10, U11, U12, U13, U14, U15, U16, U17, U18, U19, U20, U21, U22, U23, U24, U25, U26, U27, U28: WS2812-2020; LED_WS2812-2020
U29: SN74LV1T34DCKR; SOT65P210X110-5N

Connections:
/5V_SUPPLY: C21.1, C23.1, C24.1, C25.1, C26.1, C27.1, C28.1, C29.1, C30.1, C31.1, C32.1, C33.1, C34.1, C35.1, C36.1, C37.1, C38.1, C39.1, C40.1, C41.1, C42.1, C43.1, C44.1, D4.1 (K), U6.4 (VDD), U7.4 (VDD), U8.4 (VDD), U9.4 (VDD), U10.4 (VDD), U11.4 (VDD), U12.4 (VDD), U13.4 (VDD), U14.4 (VDD), U15.4 (VDD), U16.4 (VDD), U17.4 (VDD), U18.4 (VDD), U19.4 (VDD), U20.4 (VDD), U21.4 (VDD), U22.4 (VDD), U23.4 (VDD), U24.4 (VDD), U25.4 (VDD), U26.4 (VDD), U27.4 (VDD), U28.4 (VDD), U29.5 (VCC); also elsewhere on the board
/SPI_MOSI: JP4.2 (B), U29.1, U29.2 (A); also elsewhere on the board
/USB_D_N: D5.2, J9.2 (D-), TP2.1; also elsewhere on the board
/USB_D_P: D5.3, J9.3 (D+); also elsewhere on the board
/led_board/SO: JP4.1 (A), U6.3 (DI), U29.4 (Y)
/led_board/VBUS: D4.2 (A), D5.4, J9.1 (VBUS), TP1.1
GND: C21.2, C23.2, C24.2, C25.2, C26.2, C27.2, C28.2, C29.2, C30.2, C31.2, C32.2, C33.2, C34.2, C35.2, C36.2, C37.2, C38.2, C39.2, C40.2, C41.2, C42.2, C43.2, C44.2, D5.1, J9.5 (GND), U6.2 (GND), U7.2 (GND), U8.2 (GND), U9.2 (GND), U10.2 (GND), U11.2 (GND), U12.2 (GND), U13.2 (GND), U14.2 (GND), U15.2 (GND), U16.2 (GND), U17.2 (GND), U18.2 (GND), U19.2 (GND), U20.2 (GND), U21.2 (GND), U22.2 (GND), U23.2 (GND), U24.2 (GND), U25.2 (GND), U26.2 (GND), U27.2 (GND), U28.2 (GND), U29.3 (GND); also elsewhere on the board
unnamed: U6.1 (DO), U7.3 (DI)
unnamed: U7.1 (DO), U8.3 (DI)
unnamed: U8.1 (DO), U9.3 (DI)
unnamed: U10.1 (DO), U11.3 (DI)
unnamed: U9.1 (DO), U10.3 (DI)
unnamed: U11.1 (DO), U12.3 (DI)
unnamed: U12.1 (DO), U13.3 (DI)
unnamed: U13.1 (DO), U14.3 (DI)
unnamed: U14.1 (DO), U15.3 (DI)
unnamed: U15.1 (DO), U16.3 (DI)
unnamed: U16.1 (DO), U17.3 (DI)
unnamed: U17.1 (DO), U18.3 (DI)
unnamed: U18.1 (DO), U19.3 (DI)
unnamed: U19.1 (DO), U20.3 (DI)
unnamed: U20.1 (DO), U21.3 (DI)
unnamed: U21.1 (DO), U22.3 (DI)
unnamed: U22.1 (DO), U23.3 (DI)
unnamed: U23.1 (DO), U24.3 (DI)
unnamed: U24.1 (DO), U25.3 (DI)
unnamed: U25.1 (DO), U26.3 (DI)
unnamed: U26.1 (DO), U27.3 (DI)
unnamed: U27.1 (DO), U28.3 (DI)

Notes on the sheet:
LED I/O
USB I/O
Amphenol 10118193

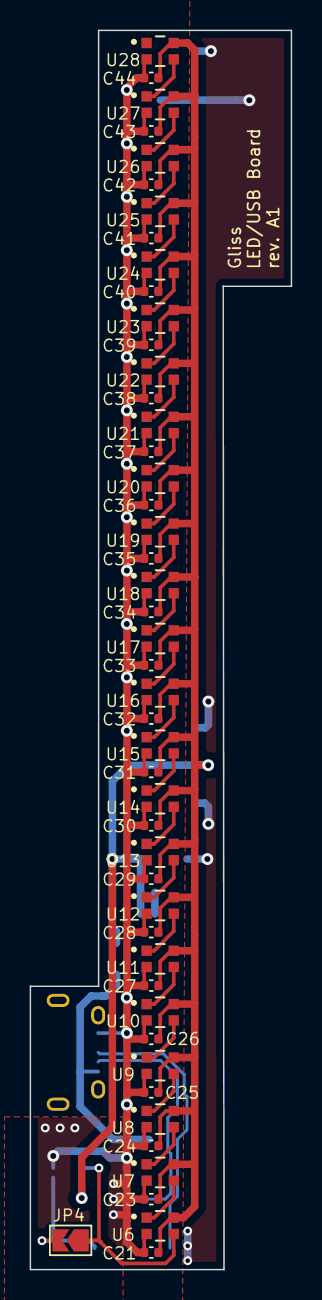
[picture p20: board gliss_led.kicad_pcb from above]

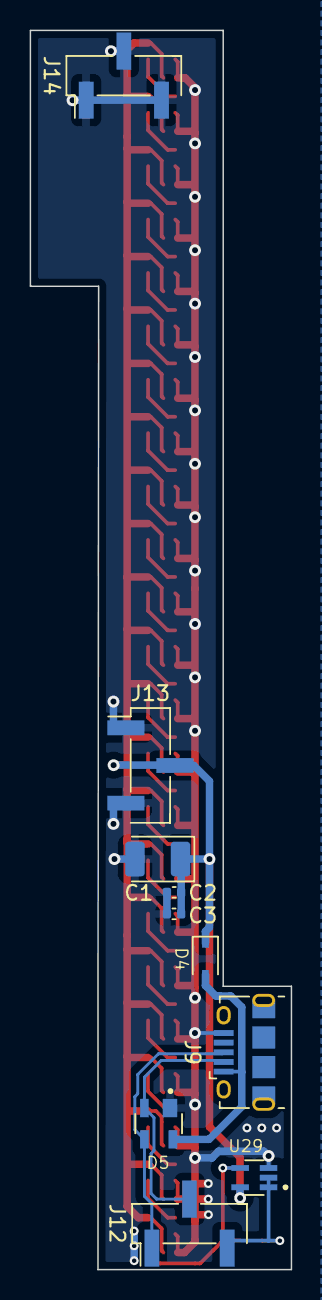
[picture p21: board gliss_led.kicad_pcb from below]

Board: 2 copper layers, 17.6 x 83.6 mm, 57 parts (10 on the bottom side), 29 nets.
